DL7AD/pecanpico6/PecanPico6.brd

## EAGLE design PecanPico6.brd (2015-11-02)

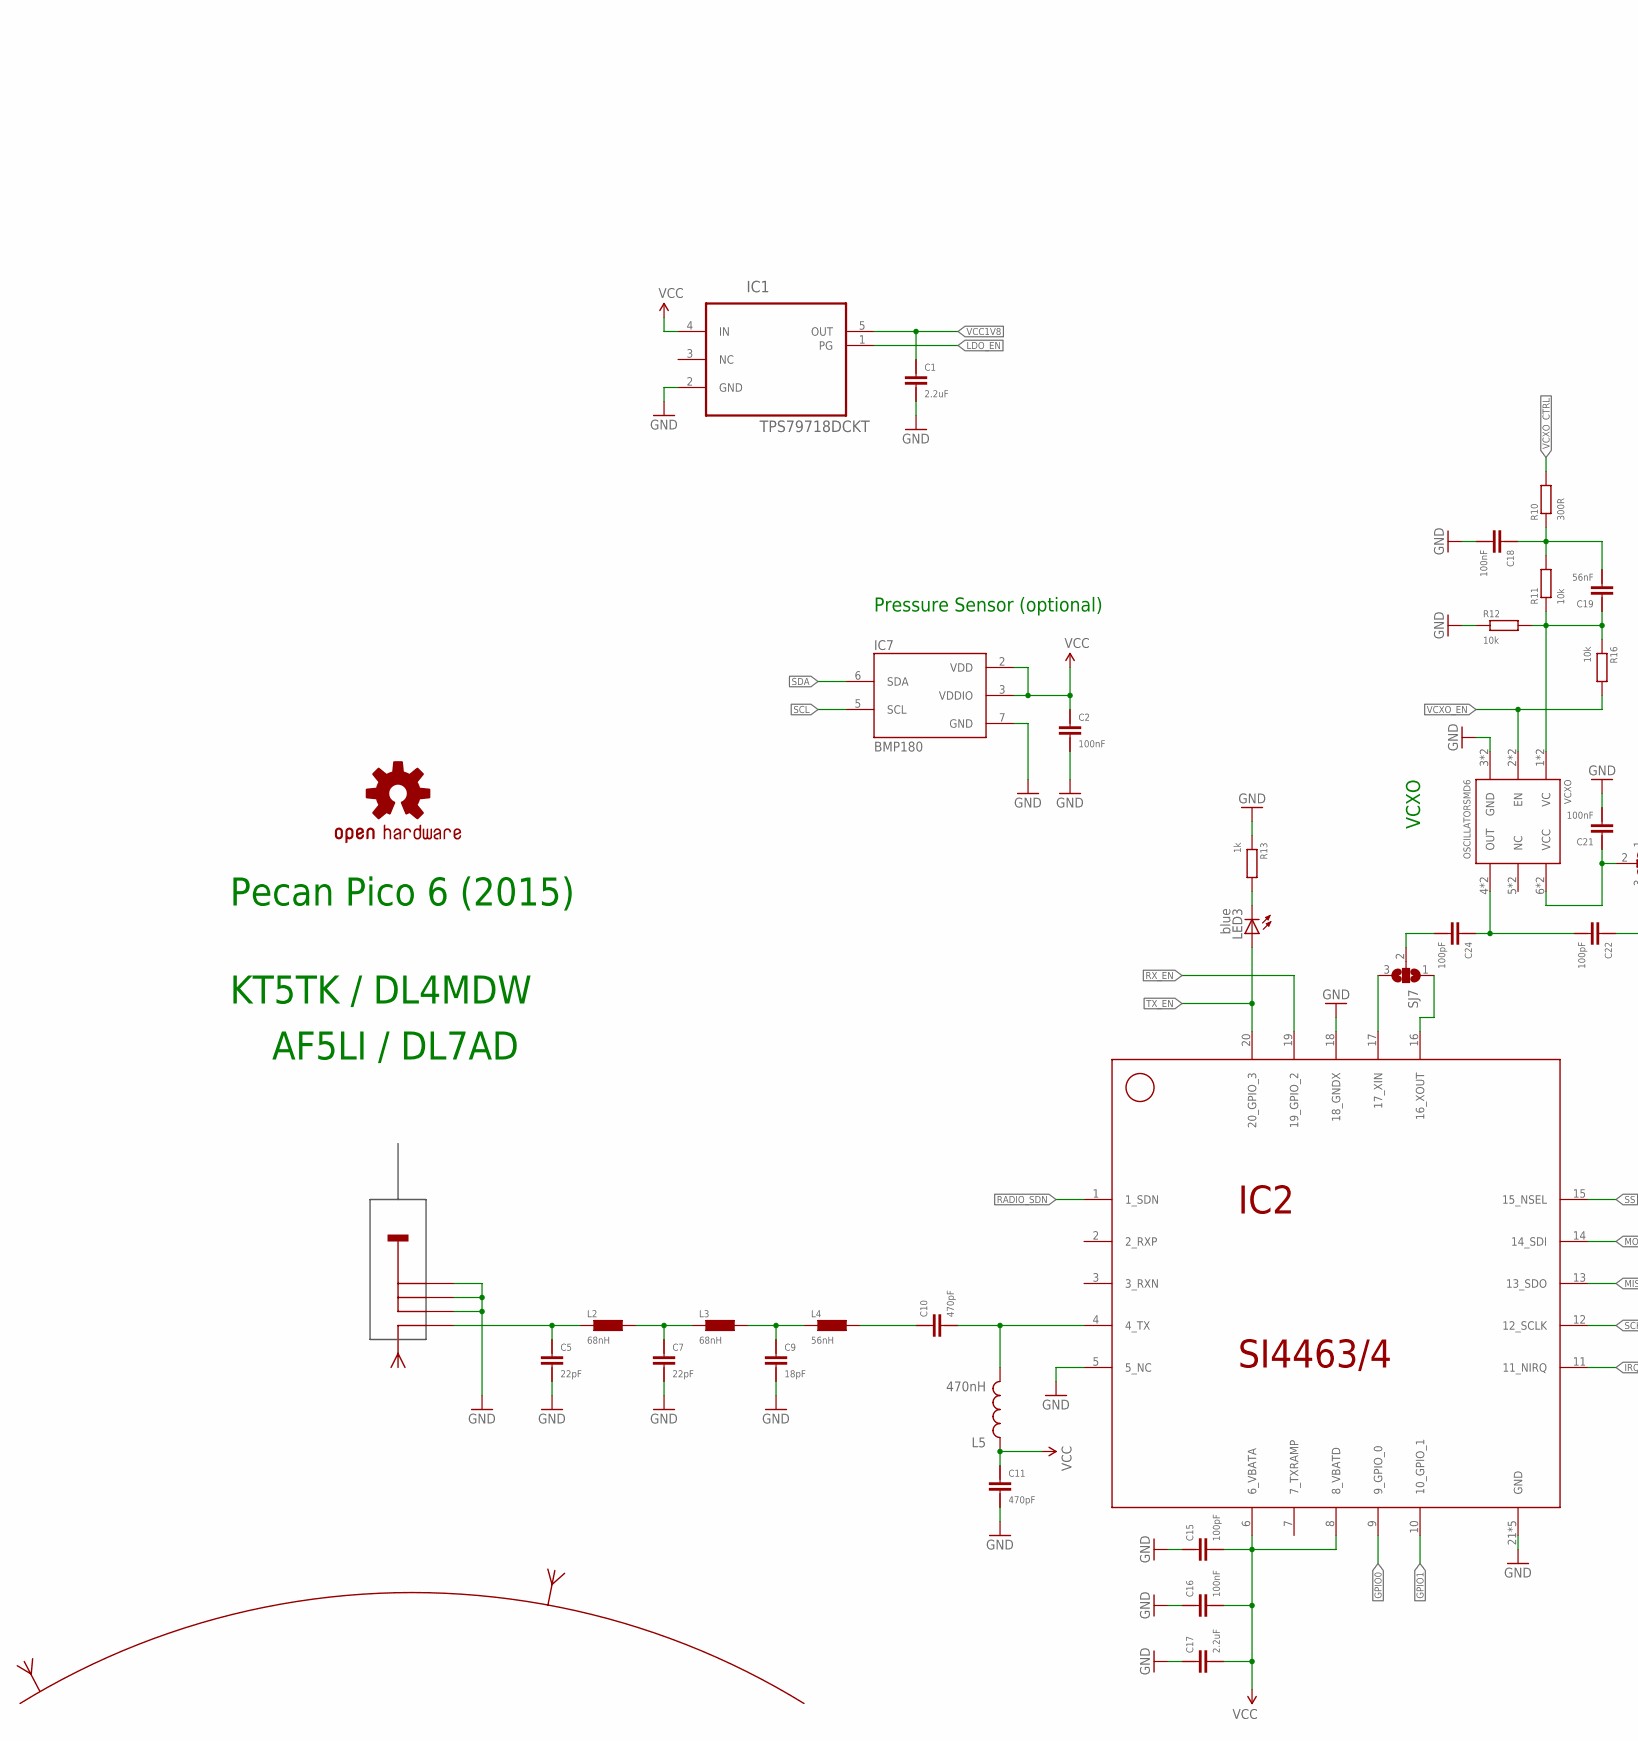
[picture p1: schematic PecanPico6.sch, part in row 1, column 1]

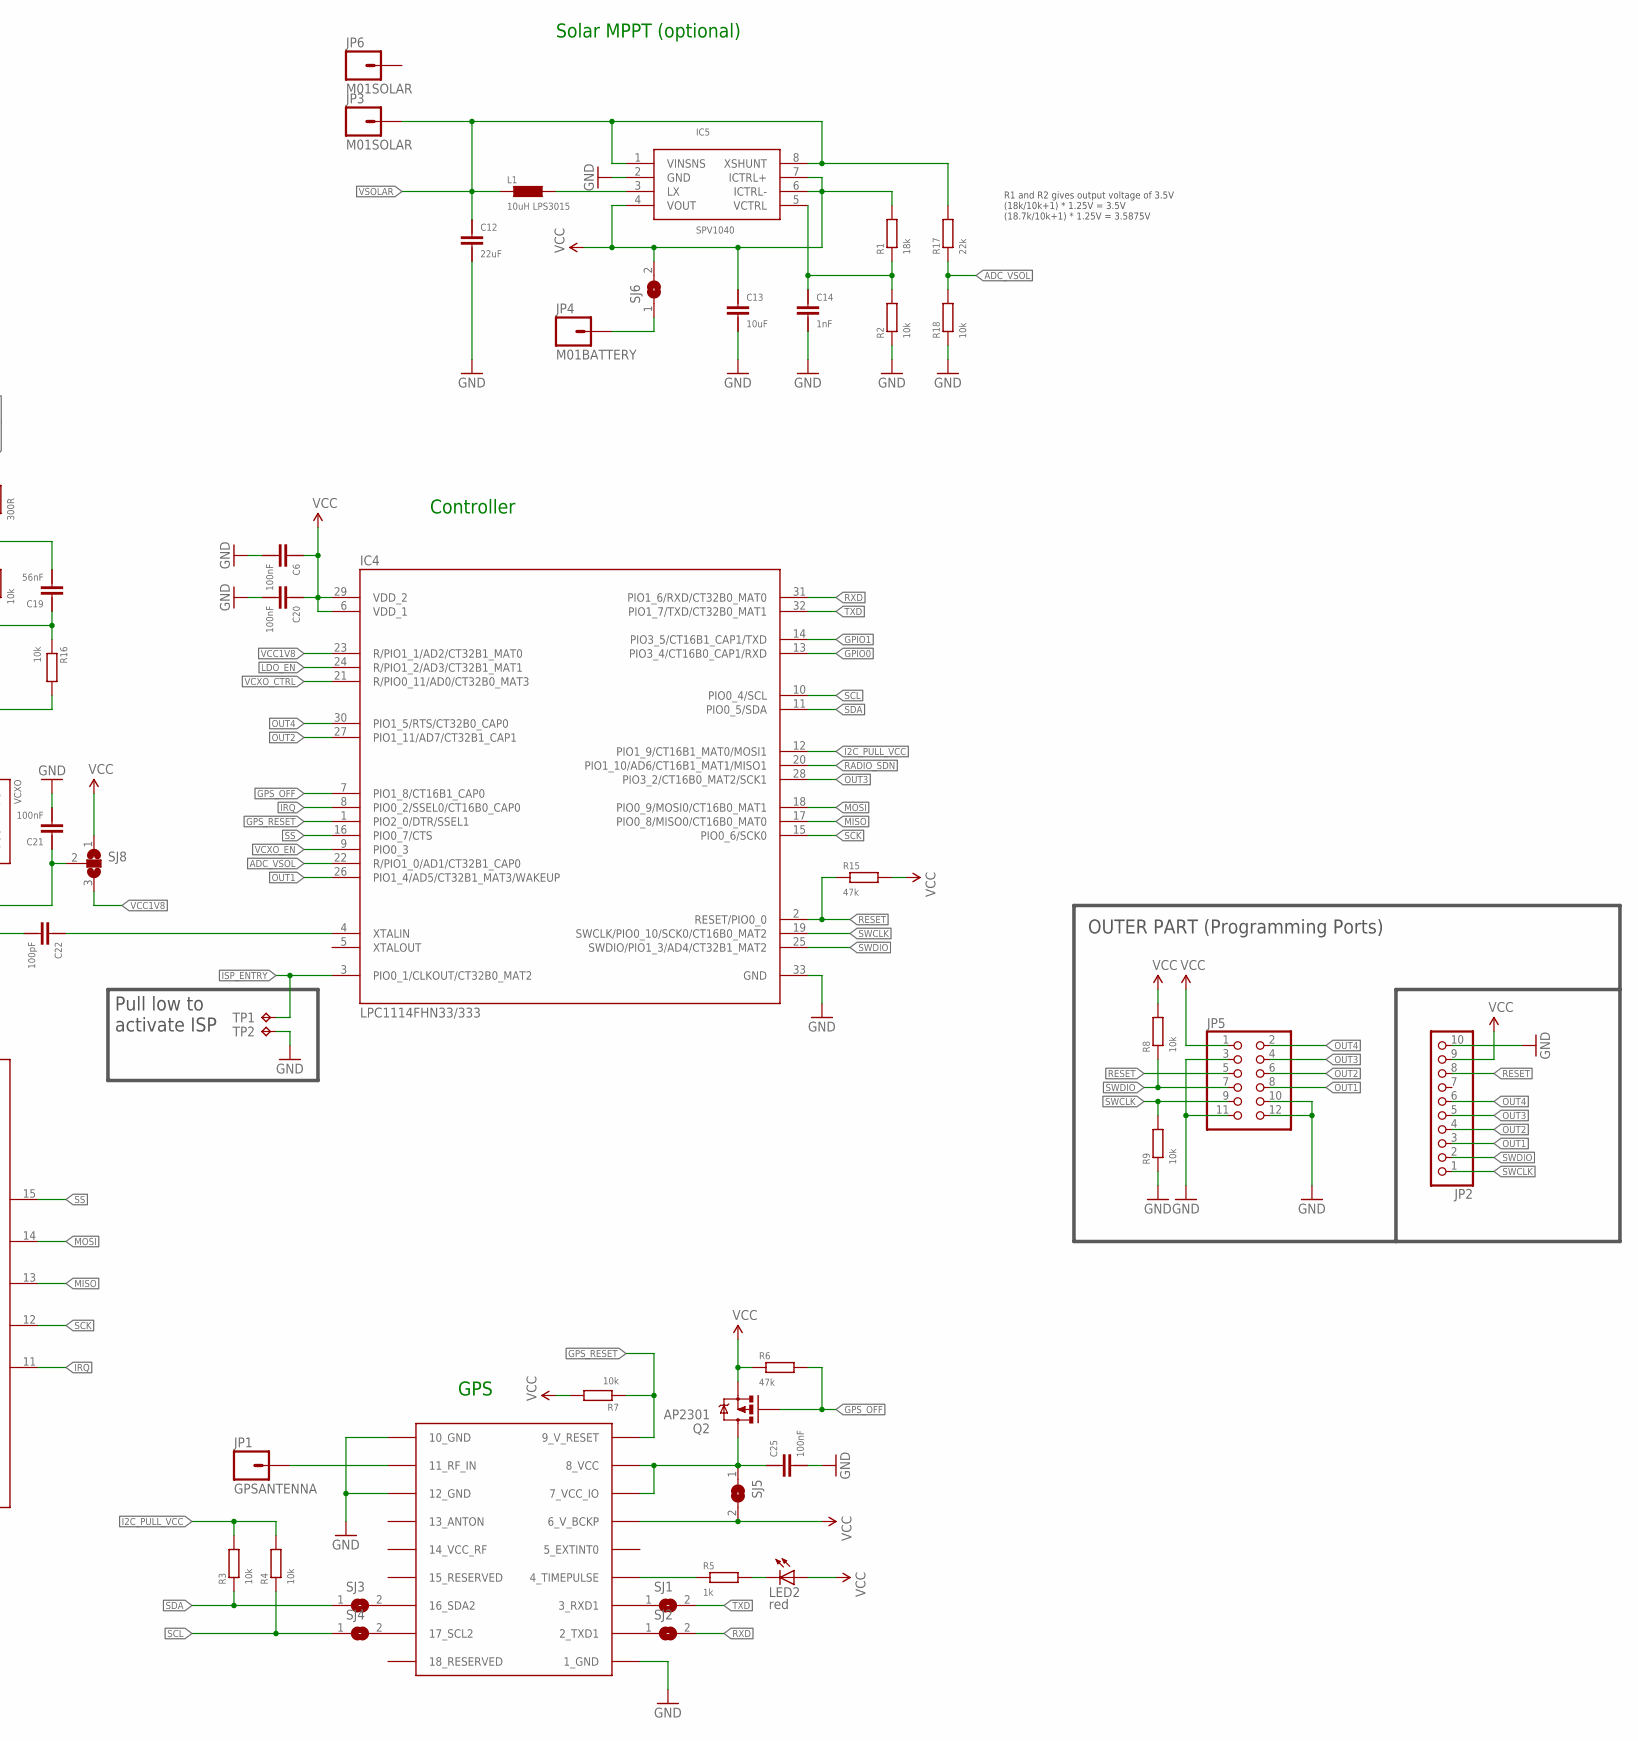
[picture p2: schematic PecanPico6.sch, part in row 1, column 2]

Parts:
C1, C17: 2.2uF; 0603; MPN 225CKH250M
C2, C6, C16, C18, C20, C21, C25: 100nF; 0402
C5, C7: 22pF; 0402
C9: 18pF; 0402
C10, C11: 470pF; 0402
C12: 22uF; 0805
C13: 10uF; 0805
C14: 1nF; 0402
C15, C22, C24: 100pF; 0402
C19: 56nF; 0402
IC1: TPS79718DCKT; SOT65P210X110-5N
IC2: SI4463/4; QFN-20
IC3: UBLOX_MAX-6
IC4: LPC1114FHN33/333; QFN65P700X700X100-33N
IC5: SPV1040; TSSOP8
IC7: BMP180
JP1: GPSANTENNA; PAD2_1.8X0.9
JP2: PINHD-1X10; 1_27X3_PINHEAD_1X10S
JP3, JP6: M01SOLAR; PAD2_1.8X0.9
JP4: M01BATTERY; PAD3.5X7.0
JP5: PINHD-2X6; 2X06
L1: 10uH LPS3015; LPS3015
L2, L3: 68nH; 0402
L4: 56nH; 0402
L5: 470nH; 0805
LED2: red; LED-0603
LED3: blue; LED-0603
LOGO1: OSHW-LOGOS; OSHW-LOGO-S
Q2: AP2301; SOT23-3
R1: 18k; 0402
R2, R3, R4, R7, R8, R9, R11, R12, R16, R18: 10k; 0402
R5, R13: 1k; 0402
R6, R15: 47k; 0402
R10: 300R; 0402
R17: 22k; 0402
SJ1, SJ2, SJ3, SJ4, SJ5, SJ6: SJ
SJ7, SJ8: SJ2W; SJ_2
TP1, TP2: TPTP07R; TP07R
U$1: ANTENNAPAD
VCXO: OSCILLATORSMD6; CRYSTAL-SMD-7.5X5.2-6PIN

Connections:
ADC_VSOL: IC4.22 (R/PIO1_0/AD1/CT32B1_CAP0), R17.P$1 (1), R18.P$2 (2)
GPIO0: IC2.9 (9_GPIO_0), IC4.13 (PIO3_4/CT16B0_CAP1/RXD)
GPIO1: IC2.10 (10_GPIO_1), IC4.14 (PIO3_5/CT16B1_CAP1/TXD)
GPS_OFF: IC4.7 (PIO1_8/CT16B1_CAP0), Q2.1 (G), R6.P$2 (2)
GPS_RESET: IC3.9_V_RESET, IC4.1 (PIO2_0/DTR/SSEL1), R7.P$1 (1)
I2C_PULL_VCC: IC4.12 (PIO1_9/CT16B1_MAT0/MOSI1), R3.P$2 (2), R4.P$2 (2)
IRQ: IC2.11 (11_NIRQ), IC4.8 (PIO0_2/SSEL0/CT16B0_CAP0)
ISP_ENTRY: IC4.3 (PIO0_1/CLKOUT/CT32B0_MAT2), TP1.TP
LDO_EN: IC1.1 (PG), IC4.24 (R/PIO1_2/AD3/CT32B1_MAT1)
MISO: IC2.13 (13_SDO), IC4.17 (PIO0_8/MISO0/CT16B0_MAT0)
MOD1: C18.P$2 (2), C19.P$1 (1), R10.P$1 (1), R11.P$2 (2)
MOSI: IC2.14 (14_SDI), IC4.18 (PIO0_9/MOSI0/CT16B0_MAT1)
unnamed: C7.P$2 (2), L2.P$2 (2), L3.P$1 (1)
unnamed: C24.P$1 (1), SJ7.2
unnamed: IC3.11_RF_IN, JP1.1
unnamed: C22.P$2 (2), IC4.4 (XTALIN)
unnamed: LED2.C, R5.P$2 (2)
unnamed: JP4.1, SJ6.1
unnamed: IC3.4_TIMEPULSE, R5.P$1 (1)
unnamed: LED3.C, R13.P$2 (2)
unnamed: IC2.17 (17_XIN), SJ7.3
unnamed: C25.P$2 (2), IC3.7_VCC_IO, IC3.8_VCC, Q2.3 (D), SJ5.1
unnamed: C22.P$1 (1), C24.P$2 (2), VCXO.4 (OUT), VCXO.4INNER (OUT)
unnamed: C21.P$2 (2), SJ8.2, VCXO.6 (VCC), VCXO.6INNER (VCC)
unnamed: IC3.3_RXD1, SJ1.1
unnamed: IC2.16 (16_XOUT), SJ7.1
unnamed: IC3.2_TXD1, SJ2.1
unnamed: C19.P$2 (2), R11.P$1 (1), R12.P$2 (2), R16.P$1 (1), VCXO.1 (VC), VCXO.1INNER (VC)
unnamed: C10.P$1 (1), IC2.4 (4_TX), L5.2
unnamed: IC3.16_SDA2, SJ3.2
unnamed: IC3.17_SCL2, SJ4.2
unnamed: C10.P$2 (2), L4.P$2 (2)
unnamed: IC5.3 (LX), L1.2_1 (2), L1.2_2 (2), L1.2_3 (2), L1.2_4 (2), L1.2_5 (2), L1.2_6 (2), L1.2_7 (2), L1.2_8 (2), L1.2_9 (2)
unnamed: C9.P$2 (2), L3.P$2 (2), L4.P$1 (1)
unnamed: C5.P$2 (2), L2.P$1 (1), U$1.ANT
unnamed: C14.P$2 (2), IC5.5 (VCTRL), R1.P$1 (1), R2.P$2 (2)
unnamed: C1.P$1 (1), C2.P$1 (1), C5.P$1 (1), C6.P$1 (1), C7.P$1 (1), C9.P$1 (1), C11.P$1 (1), C12.P$1 (1), C13.P$1 (1), C14.P$1 (1), C15.P$2 (2), C16.P$2 (2), C17.P$2 (2), C18.P$1 (1), C20.P$1 (1), C21.P$1 (1), C25.P$1 (1), IC1.2 (GND), IC2.5 (5_NC), IC2.18 (18_GNDX), IC2.21 (GND), IC2.22 (GND), IC2.23 (GND), IC2.24 (GND), IC2.25 (GND), IC3.1_GND, IC3.10_GND, IC3.12_GND, IC4.33 (GND), IC5.2 (GND), IC7.7 (GND), JP2.10, JP5.3, JP5.10, JP5.11, JP5.12, R2.P$1 (1), R9.P$1 (1), R12.P$1 (1), R13.P$1 (1), R18.P$1 (1), TP2.TP, U$1.GND1, U$1.GND2, U$1.GND3, VCXO.3 (GND), VCXO.3INNER (GND)
OUT1: IC4.26 (PIO1_4/AD5/CT32B1_MAT3/WAKEUP), JP2.3, JP5.8
OUT2: IC4.27 (PIO1_11/AD7/CT32B1_CAP1), JP2.4, JP5.6
OUT3: IC4.28 (PIO3_2/CT16B0_MAT2/SCK1), JP2.5, JP5.4
OUT4: IC4.30 (PIO1_5/RTS/CT32B0_CAP0), JP2.6, JP5.2
RADIO_SDN: IC2.1 (1_SDN), IC4.20 (PIO1_10/AD6/CT16B1_MAT1/MISO1)
RESET: IC4.2 (RESET/PIO0_0), JP2.8, JP5.5, R15.P$1 (1)
RXD: IC4.31 (PIO1_6/RXD/CT32B0_MAT0), SJ2.2
RX_EN: IC2.19 (19_GPIO_2)
SCK: IC2.12 (12_SCLK), IC4.15 (PIO0_6/SCK0)
SCL: IC4.10 (PIO0_4/SCL), IC7.5 (SCL), R4.P$1 (1), SJ4.1
SDA: IC4.11 (PIO0_5/SDA), IC7.6 (SDA), R3.P$1 (1), SJ3.1
SS: IC2.15 (15_NSEL), IC4.16 (PIO0_7/CTS)
SWCLK: IC4.19 (SWCLK/PIO0_10/SCK0/CT16B0_MAT2), JP2.1, JP5.9, R9.P$2 (2)
SWDIO: IC4.25 (SWDIO/PIO1_3/AD4/CT32B1_MAT2), JP2.2, JP5.7, R8.P$1 (1)
TXD: IC4.32 (PIO1_7/TXD/CT32B0_MAT1), SJ1.2
TX_EN: IC2.20 (20_GPIO_3), LED3.A
VCC1V8: C1.P$2 (2), IC1.5 (OUT), IC4.23 (R/PIO1_1/AD2/CT32B1_MAT0), SJ8.3
VCC15: C2.P$2 (2), C6.P$2 (2), C11.P$2 (2), C13.P$2 (2), C15.P$1 (1), C16.P$1 (1), C17.P$1 (1), C20.P$2 (2), IC1.4 (IN), IC2.6 (6_VBATA), IC2.8 (8_VBATD), IC3.6_V_BCKP, IC4.6 (VDD_1), IC4.29 (VDD_2), IC5.4 (VOUT), IC5.6 (ICTRL-), IC5.7 (ICTRL+), IC7.2 (VDD), IC7.3 (VDDIO), JP2.9, JP5.1, L5.1, LED2.A, Q2.2 (S), R1.P$2 (2), R6.P$1 (1), R7.P$2 (2), R8.P$2 (2), R15.P$2 (2), SJ5.2, SJ6.2, SJ8.1
VCXO_CTRL: IC4.21 (R/PIO0_11/AD0/CT32B0_MAT3), R10.P$2 (2)
VCXO_EN: IC4.9 (PIO0_3), R16.P$2 (2), VCXO.2 (EN), VCXO.2INNER (EN)
VSOLAR: C12.P$2 (2), IC5.1 (VINSNS), IC5.8 (XSHUNT), JP3.1, L1.1_1 (1), L1.1_2 (1), L1.1_3 (1), L1.1_4 (1), L1.1_5 (1), L1.1_6 (1), L1.1_7 (1), L1.1_8 (1), L1.1_9 (1), R17.P$2 (2)

Notes on the sheet:
KT5TK / DL4MDW
Controller
GPS
VCXO
Pressure Sensor (optional)
Pecan Pico 6 (2015)
Solar MPPT (optional)
AF5LI / DL7AD
OUTER PART (Programming Ports)
Pull low to
activate ISP
R1 and R2 gives output voltage of 3.5V (18k/10k+1) * 1.25V = 3.5V (18.7k/10k+1) * 1.25V = 3.5875V

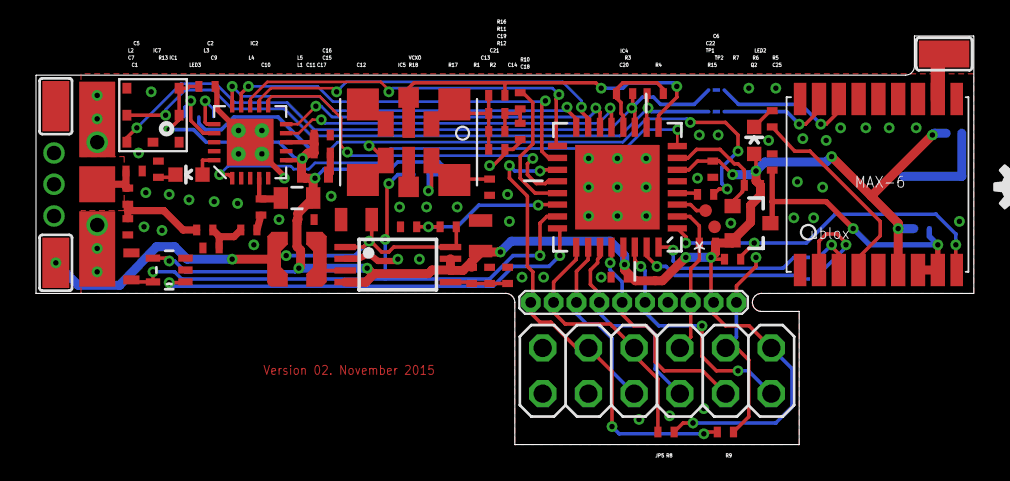
[picture p3: board PecanPico6.brd from above]

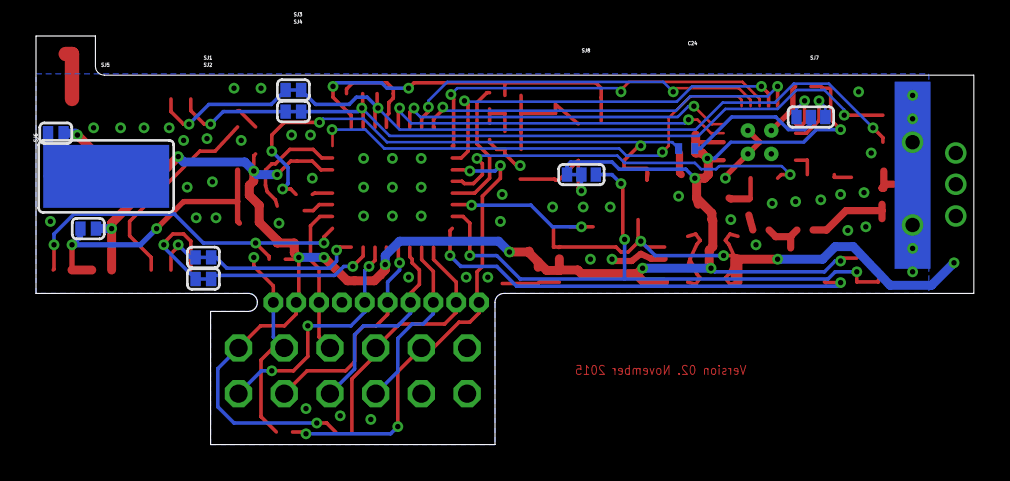
[picture p4: board PecanPico6.brd from below]

Board: 2 copper layers, 52.1 x 22.7 mm, 71 parts (10 on the bottom side), 57 nets.
