DL7AD/pecanpico6/(commit log)

2015-03-17 Changed net class restrictions, fixed DRC errors on board
    [PecanPico6.brd, PecanPico6.sch]
2015-03-17 Corrected 'UART TXD,RXD switched' error
    [PecanPico6.brd, PecanPico6.sch]
2015-03-18 Moved misplaced IC label
    [PecanPico6.brd]
2015-03-18 Added hackvana gerber files
    [PecanPico6_board_outline.gm1, PecanPico6_bottom_copper.gbl, PecanPico6_bottom_paste.gbp, PecanPico6_bottom_silk.gbo, PecanPico6_bottom_soldermask.gbs, PecanPico6_top_copper.gtl, PecanPico6_top_paste.gtp, PecanPico6_top_silk.gto]
2015-03-30 Added interrupt signal,option between XIN and XOUT
    [PecanPico6.brd, PecanPico6.sch]
2015-03-30 mproved SDA SCL signal routing
    [PecanPico6.brd]
2015-04-03 Added version date
    [PecanPico6.brd]
2015-04-03 Changed version date to copper layer
    [PecanPico6.brd]
2015-04-06 Moved some components to make it look better
    [PecanPico6.sch]
2015-04-06 Recreated GERBERs
    [PecanPico6_bottom_copper.gbl, PecanPico6_bottom_paste.gbp, PecanPico6_bottom_silk.gbo, PecanPico6_bottom_soldermask.gbs, PecanPico6_top_copper.gtl, PecanPico6_top_paste.gtp, PecanPico6_top_silk.gto, PecanPico6_top_soldermask.gts]
2015-11-02 Created version 6b Removed RX part Removed UART pinheader below GPS module Enlarged Solar pad Fixed VCC_IO pin connection at GPS Enlarged Board for holes
    [PecanPico6.brd, PecanPico6.sch]
2015-11-02 Moved solar pads
    [PecanPico6.brd, PecanPico6.sch]
2015-11-02 Fixed DRC errors
    [PecanPico6.brd]
2015-11-02 Updated gerber files
    [PecanPico6-Vcut.gbr, PecanPico6_board_outline.gm1, PecanPico6_bottom_copper.gbl, PecanPico6_bottom_paste.gbp, PecanPico6_bottom_silk.gbo, PecanPico6_bottom_soldermask.gbs, PecanPico6_top_copper.gtl, PecanPico6_top_paste.gtp]
