DL7AD/pecanpico6/(notices)

Notices in the files:
parts and their libraries:
SparkFun-FreqCtrl_TK: Licensing: CC v3.0 Share-Alike You are welcome to use this library for commercial purposes.
SparkFun-DiscreteSemi: Licensing: Creative Commons ShareAlike 4.0 International - https://creativecommons.org/licenses/by-sa/4.0
